arturo182/cnc_featherwing/schematics.pdf

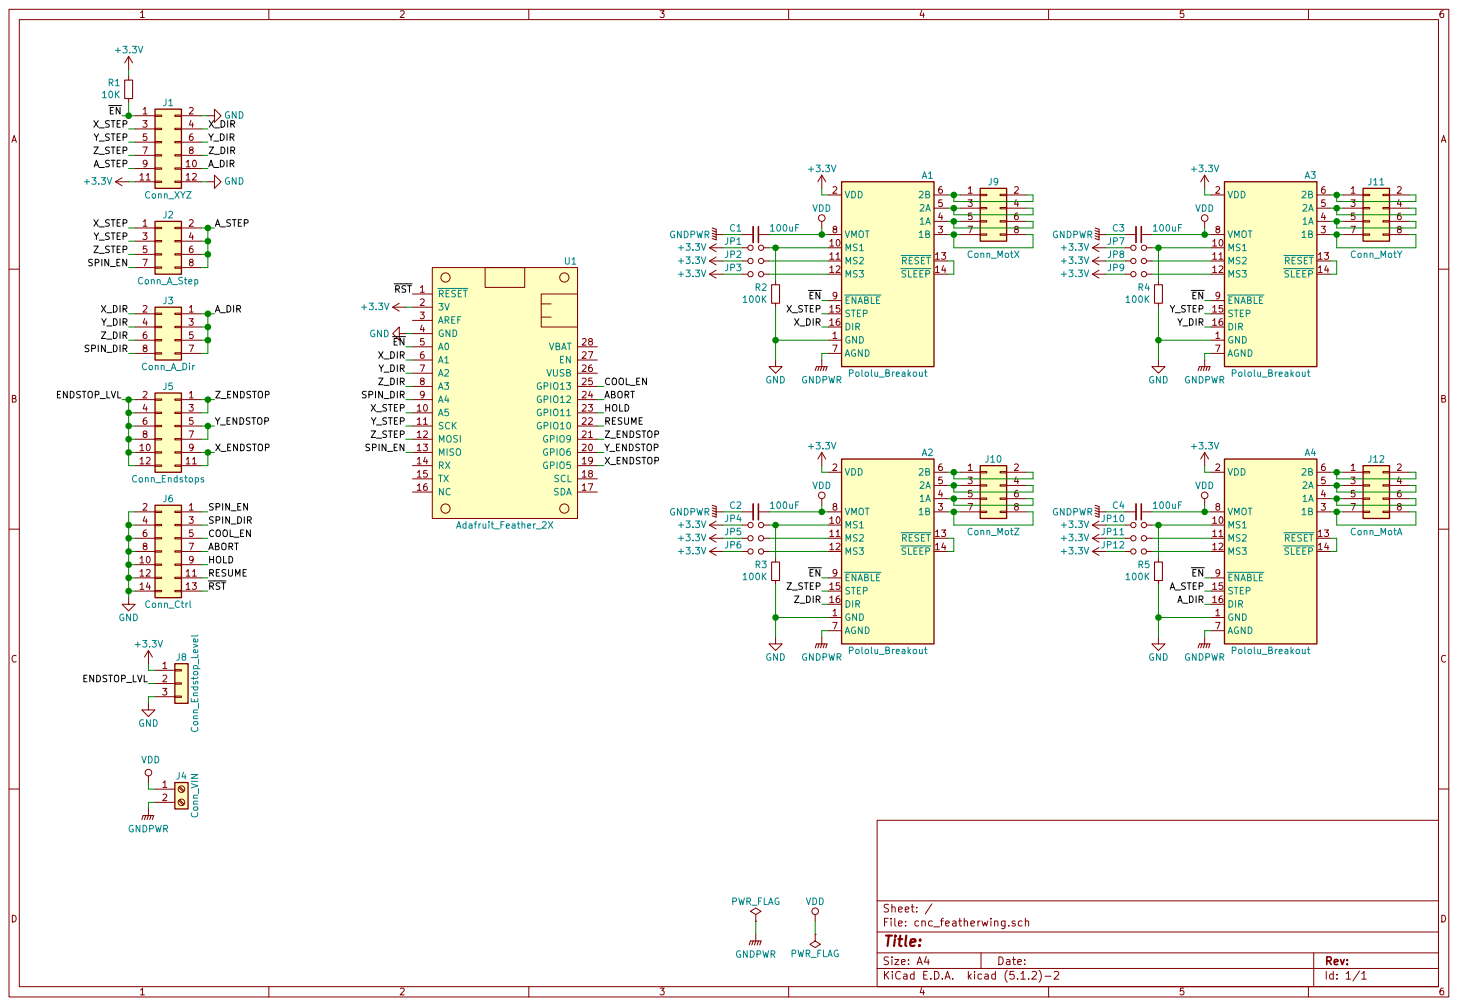
[picture p5: page 1]
