arturo182/cnc_featherwing/cnc_featherwing.kicad_pcb

## KiCad design cnc_featherwing.kicad_pcb (2019-08-11)

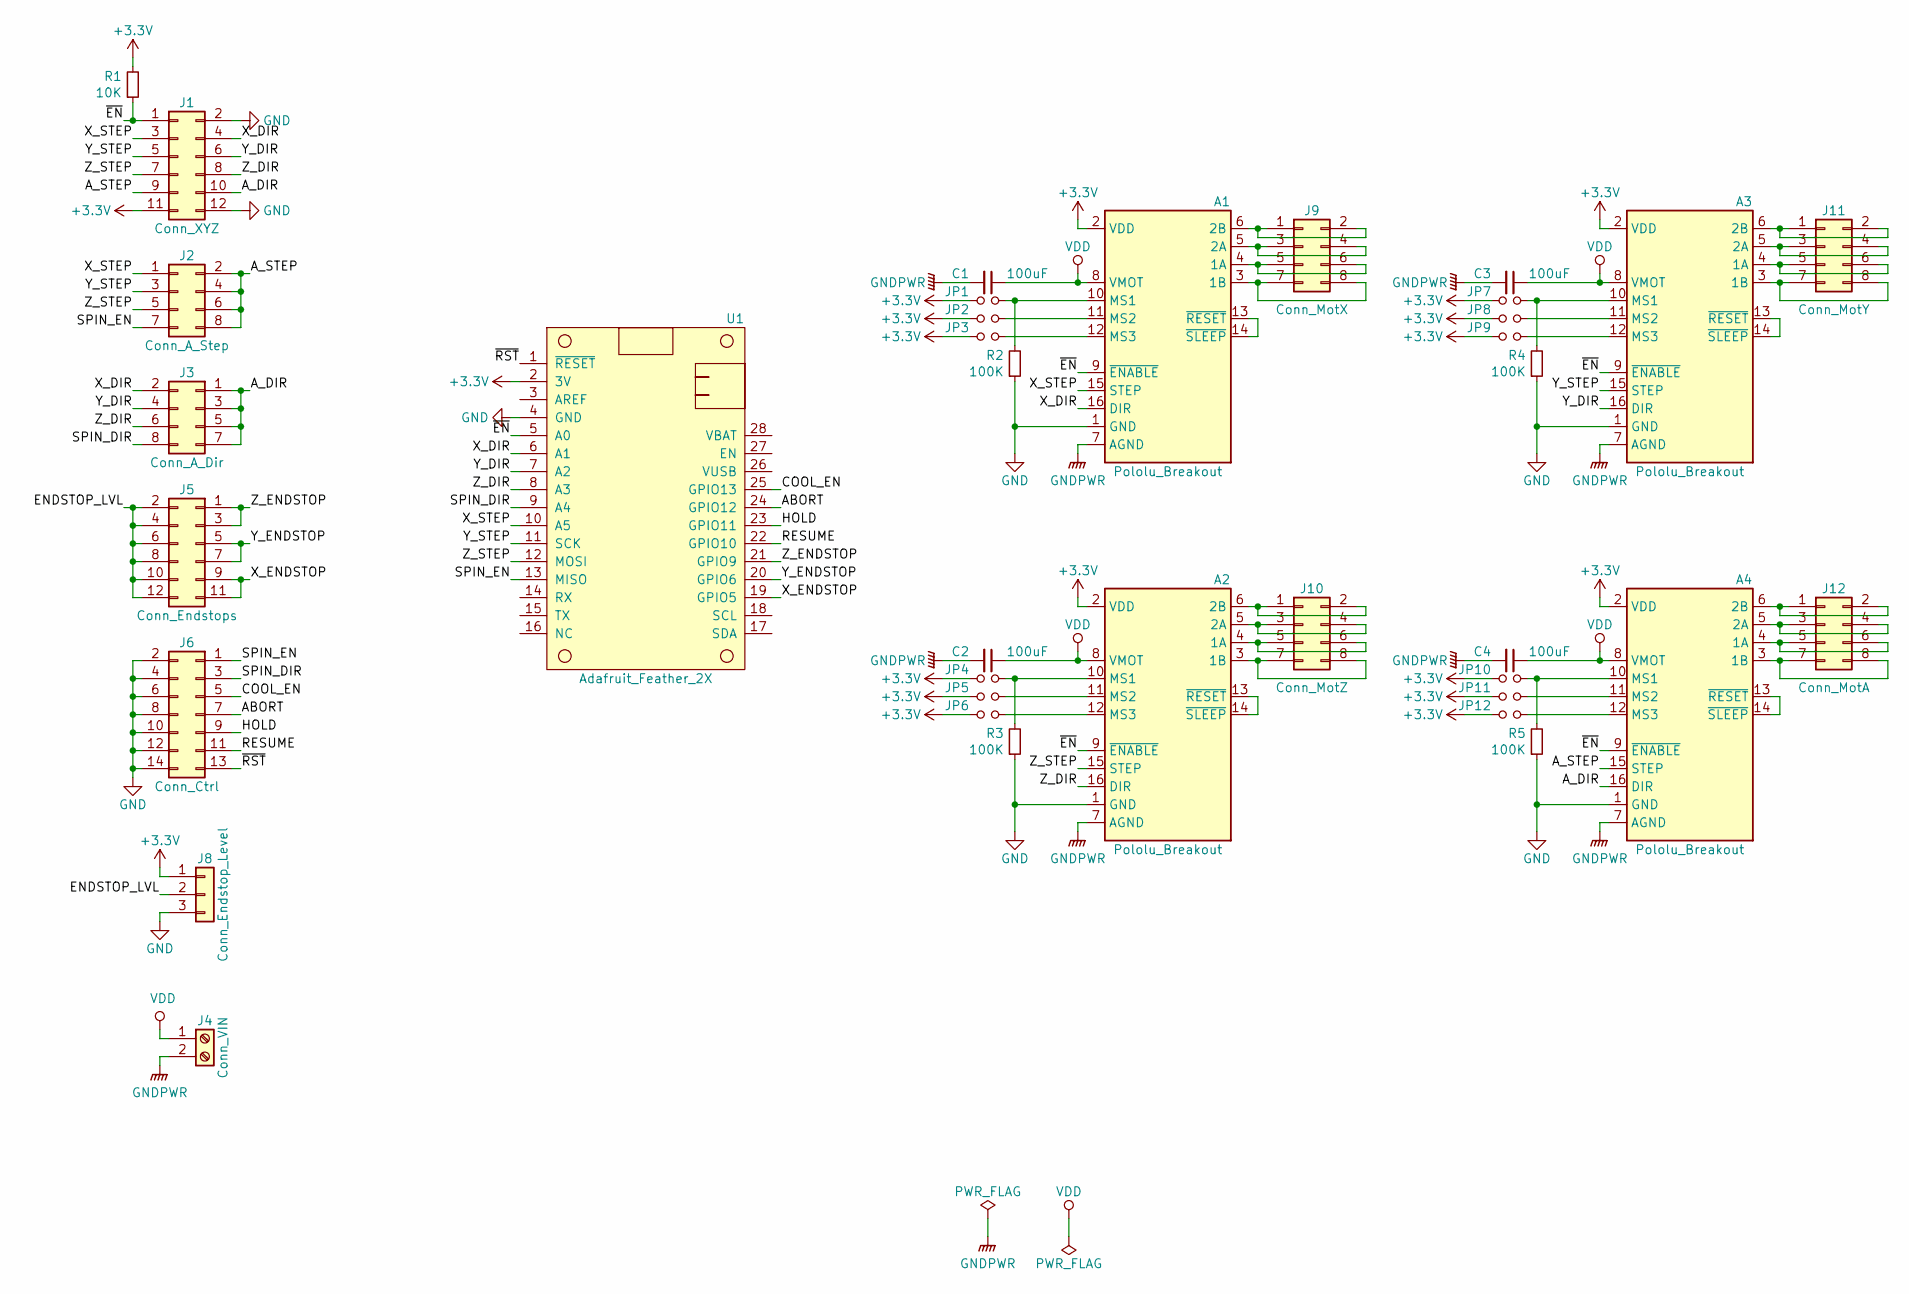
[picture p6: schematic cnc_featherwing.sch]

Parts:
A1, A2, A3, A4: Pololu_Breakout; Pololu_Breakout-16_15.2x20.3mm
C1, C2, C3, C4: 100uF; CP_Elec_6.3x7.7
J1: Conn_XYZ; PinHeader_2x06_P2.54mm_Vertical
J2: Conn_A_Step; PinHeader_2x04_P2.54mm_Vertical
J3: Conn_A_Dir; PinHeader_2x04_P2.54mm_Vertical
J4: Conn_VIN; TerminalBlock_bornier-2_P5.08mm
J5: Conn_Endstops; PinHeader_2x06_P2.54mm_Vertical
J6: Conn_Ctrl; PinHeader_2x07_P2.54mm_Vertical
J8: Conn_Endstop_Level; PinHeader_1x03_P2.54mm_Vertical
J9: Conn_MotX; PinHeader_2x04_P2.54mm_Vertical
J10: Conn_MotZ; PinHeader_2x04_P2.54mm_Vertical
J11: Conn_MotY; PinHeader_2x04_P2.54mm_Vertical
J12: Conn_MotA; PinHeader_2x04_P2.54mm_Vertical
JP1, JP4, JP7, JP10: Jumper_MS1; PinHeader_1x02_P2.54mm_Vertical
JP2, JP5, JP8, JP11: Jumper_MS2; PinHeader_1x02_P2.54mm_Vertical
JP3, JP6, JP9, JP12: Jumper_MS3; PinHeader_1x02_P2.54mm_Vertical
R1: 10K; R_0603_1608Metric
R2, R3, R4, R5: 100K; R_0603_1608Metric
U1: Adafruit_Feather_2X; FeatherWing

Connections:
+3V3: A1.2 (VDD), A2.2 (VDD), A3.2 (VDD), A4.2 (VDD), J1.11, J8.1, JP1.1, JP2.1, JP3.1, JP4.1, JP5.1, JP6.1, JP7.1, JP8.1, JP9.1, JP10.1, JP11.1, JP12.1, R1.2, U1.2 (3V)
/ABORT: J6.7, U1.24 (GPIO12)
/A_DIR: A4.16 (DIR), J1.10, J3.1, J3.3, J3.5, J3.7
/A_STEP: A4.15 (STEP), J1.9, J2.2, J2.4, J2.6, J2.8
/COOL_EN: J6.5, U1.25 (GPIO13)
/ENDSTOP_LVL: J5.2, J5.4, J5.6, J5.8, J5.10, J5.12, J8.2
/HOLD: J6.9, U1.23 (GPIO11)
/RESUME: J6.11, U1.22 (GPIO10)
/SPIN_DIR: J3.8, J6.3, U1.9 (A4)
/SPIN_EN: J2.7, J6.1, U1.13 (MISO)
/X_DIR: A1.16 (DIR), J1.4, J3.2, U1.6 (A1)
/X_ENDSTOP: J5.9, J5.11, U1.19 (GPIO5)
/X_STEP: A1.15 (STEP), J1.3, J2.1, U1.10 (A5)
/Y_DIR: A3.16 (DIR), J1.6, J3.4, U1.7 (A2)
/Y_ENDSTOP: J5.5, J5.7, U1.20 (GPIO6)
/Y_STEP: A3.15 (STEP), J1.5, J2.3, U1.11 (SCK)
/Z_DIR: A2.16 (DIR), J1.8, J3.6, U1.8 (A3)
/Z_ENDSTOP: J5.1, J5.3, U1.21 (GPIO9)
/Z_STEP: A2.15 (STEP), J1.7, J2.5, U1.12 (MOSI)
/~EN~: A1.9 (~ENABLE), A2.9 (~ENABLE), A3.9 (~ENABLE), A4.9 (~ENABLE), J1.1, R1.1, U1.5 (A0)
/~RST~: J6.13, U1.1 (~RESET~)
GND: A1.1 (GND), A2.1 (GND), A3.1 (GND), A4.1 (GND), J1.2, J1.12, J6.2, J6.4, J6.6, J6.8, J6.10, J6.12, J6.14, J8.3, R2.1, R3.1, R4.1, R5.1, U1.4 (GND)
GNDPWR: A1.7 (AGND), A2.7 (AGND), A3.7 (AGND), A4.7 (AGND), C1.2, C2.2, C3.2, C4.2, J4.2
unnamed: A1.3 (1B), J9.7, J9.8
unnamed: A1.4 (1A), J9.5, J9.6
unnamed: A1.5 (2A), J9.3, J9.4
unnamed: A1.6 (2B), J9.1, J9.2
unnamed: A1.10 (MS1), JP1.2, R2.2
unnamed: A1.11 (MS2), JP2.2
unnamed: A1.12 (MS3), JP3.2
unnamed: A1.13 (~RESET), A1.14 (~SLEEP)
unnamed: A2.3 (1B), J10.7, J10.8
unnamed: A2.4 (1A), J10.5, J10.6
unnamed: A2.5 (2A), J10.3, J10.4
unnamed: A2.6 (2B), J10.1, J10.2
unnamed: A2.10 (MS1), JP4.2, R3.2
unnamed: A2.11 (MS2), JP5.2
unnamed: A2.12 (MS3), JP6.2
unnamed: A2.13 (~RESET), A2.14 (~SLEEP)
unnamed: A3.3 (1B), J11.7, J11.8
unnamed: A3.4 (1A), J11.5, J11.6
unnamed: A3.5 (2A), J11.3, J11.4
unnamed: A3.6 (2B), J11.1, J11.2
unnamed: A3.10 (MS1), JP7.2, R4.2
unnamed: A3.11 (MS2), JP8.2
unnamed: A3.12 (MS3), JP9.2
unnamed: A3.13 (~RESET), A3.14 (~SLEEP)
unnamed: A4.3 (1B), J12.7, J12.8
unnamed: A4.4 (1A), J12.5, J12.6
unnamed: A4.5 (2A), J12.3, J12.4
unnamed: A4.6 (2B), J12.1, J12.2
unnamed: A4.10 (MS1), JP10.2, R5.2
unnamed: A4.11 (MS2), JP11.2
unnamed: A4.12 (MS3), JP12.2
unnamed: A4.13 (~RESET), A4.14 (~SLEEP)
VDD: A1.8 (VMOT), A2.8 (VMOT), A3.8 (VMOT), A4.8 (VMOT), C1.1, C2.1, C3.1, C4.1, J4.1

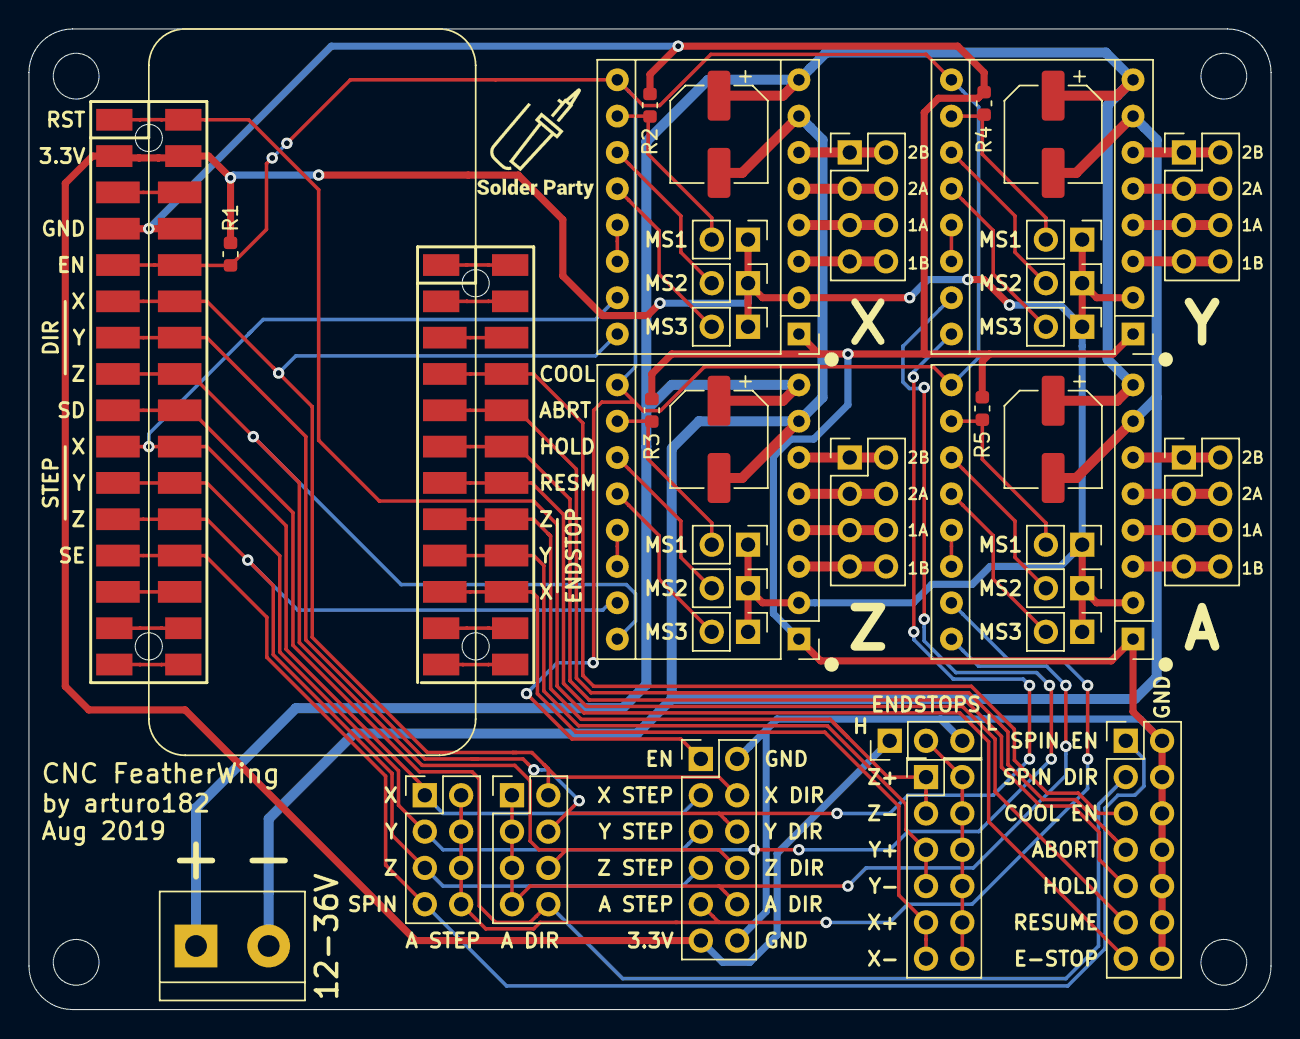
[picture p7: board cnc_featherwing.kicad_pcb from above]

Board: 2 copper layers, 86.9 x 68.6 mm, 37 parts (0 on the bottom side), 56 nets.
