arturo182/cnc_featherwing/(commit log)

2019-08-11 Initial import
    [cnc_featherwing.kicad_pcb, cnc_featherwing.sch]
2019-08-13 Add schematics
